harbaum/ftduino32/README.md

# ftDuino32

The ftDuino32 is the big brother of the [ftDuino](http://ftDuino.de). Read [more about the ftDuino32](https://harbaum.github.io/ftduino32/www/).

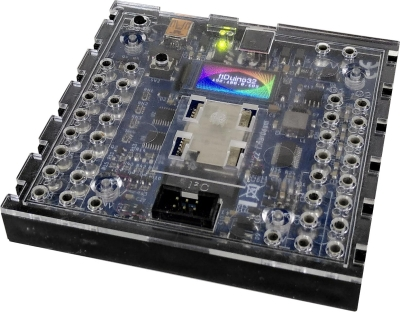
[picture p1: www/images/ftduino32.jpg]
