harbaum/ftduino32/micropython/README.md

# ftDuino32 MicroPython

MicroPython core for the ftDuino32. The files here are used by
[uPIDE](http://github.com/harbaum/upide) when flashing a ftDuino32.

## [ftduino32-20230504-v1.20.0.bin](ftduino32-20230504-v1.20.0.bin)

- MicroPython v1.20.0
- [esp32_machine_counter branch](https://github.com/jonathanhogg/micropython/tree/esp32_machine_counter)
- [MAC address patch applied](modmachine_mac_addr.patch)
- Built with ESP-IDF 4.4.4
