harbaum/ftduino32/www/images/arduino_lab.png

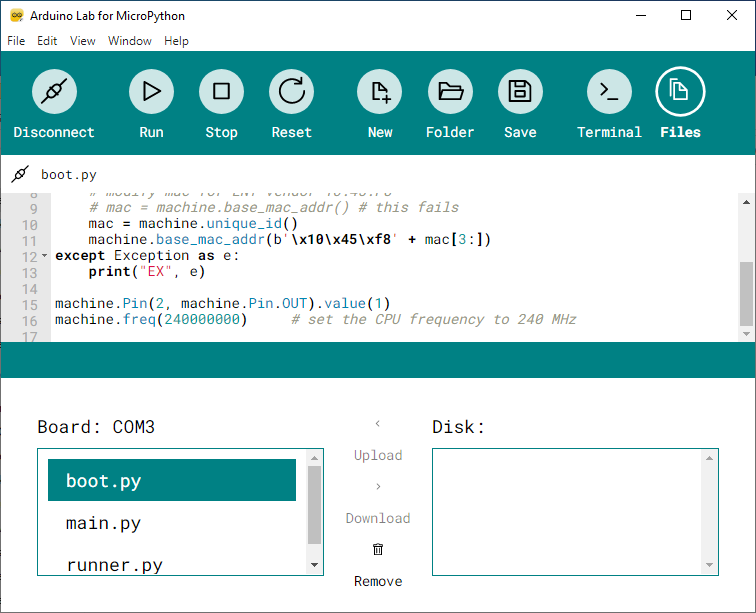
www/images/arduino_lab.png
