harbaum/ftduino32/www/images/mpy_jama.png

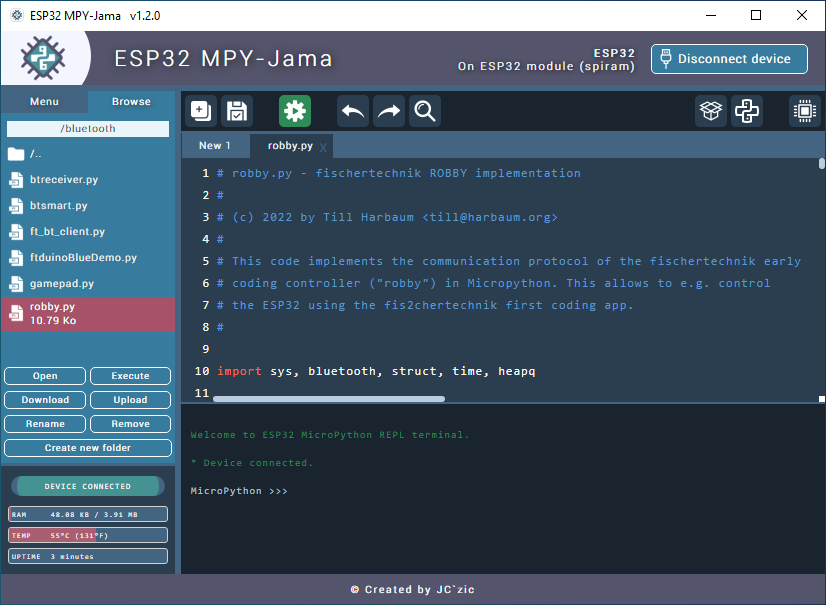
www/images/mpy_jama.png
