harbaum/ftduino32/www/images/pycharm.png

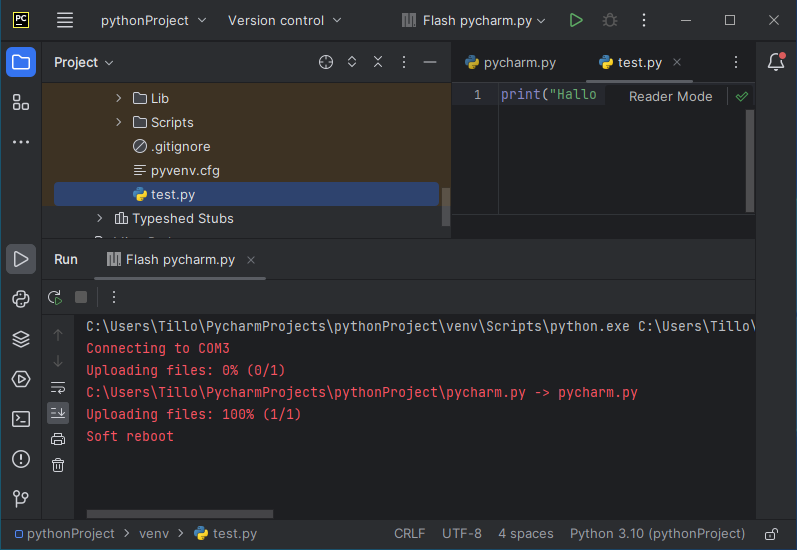
www/images/pycharm.png
