harbaum/ftduino32/www/images/thonny.png

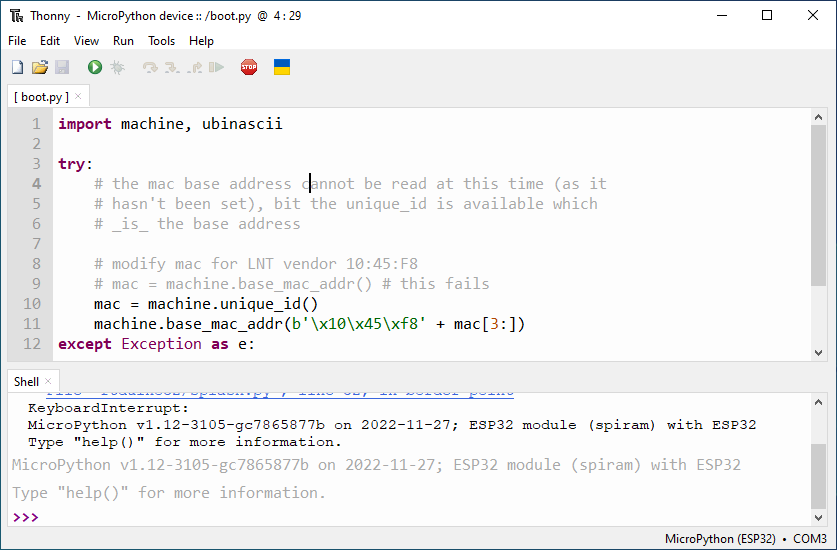
www/images/thonny.png
