harbaum/ftduino32/www/images/upide.png

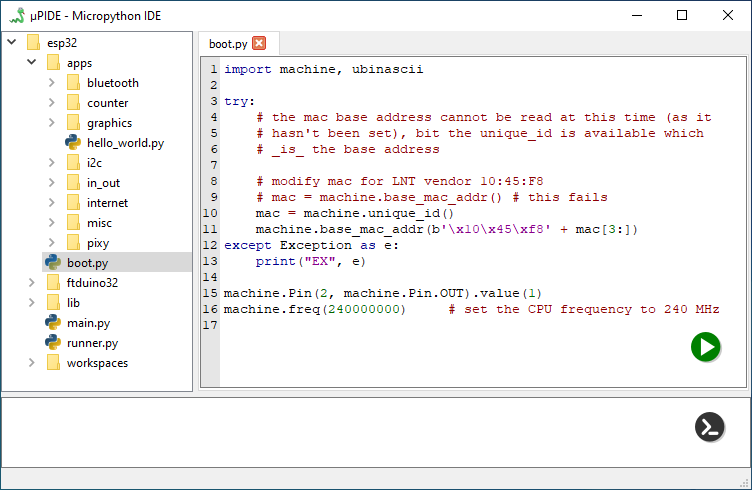
www/images/upide.png
