harbaum/ftduino32/hardware/3d/HRO  TYPE-C-31-M-12.step

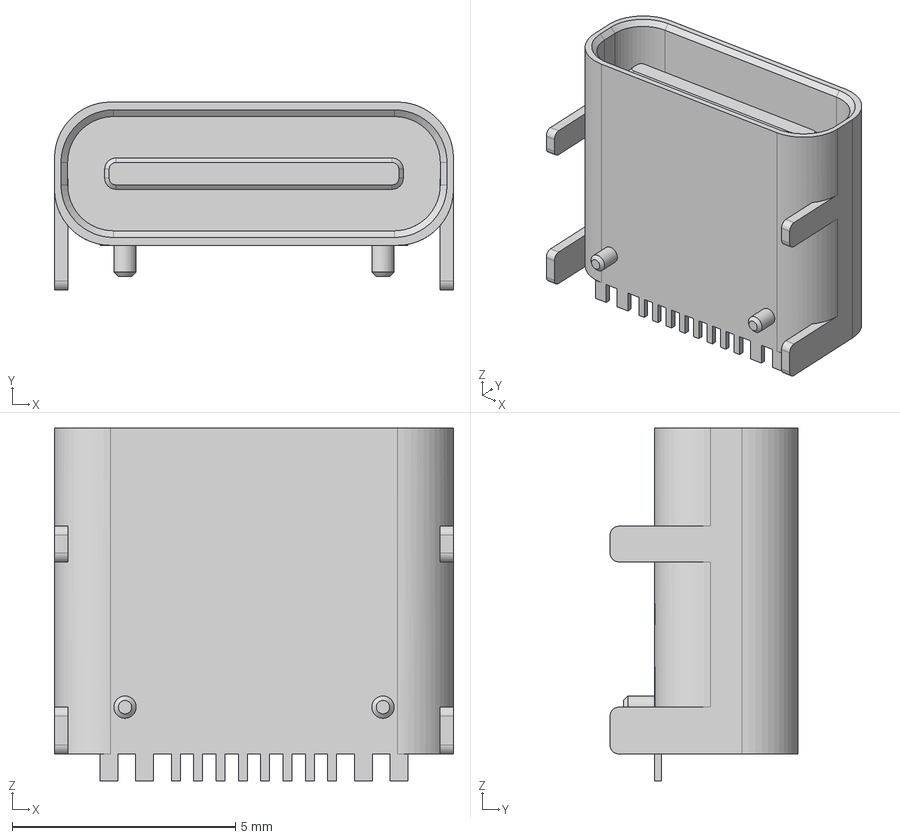
[picture p7: CAD file, 2023-12-07]
hardware/3d/HRO TYPE-C-31-M-12.step
8.94 x 4.21 x 7.90 mm
