harbaum/ftduino32/hardware/ftduino32.kicad_pcb

## KiCad design hardware/ftduino32.kicad_pcb (2023-12-07)

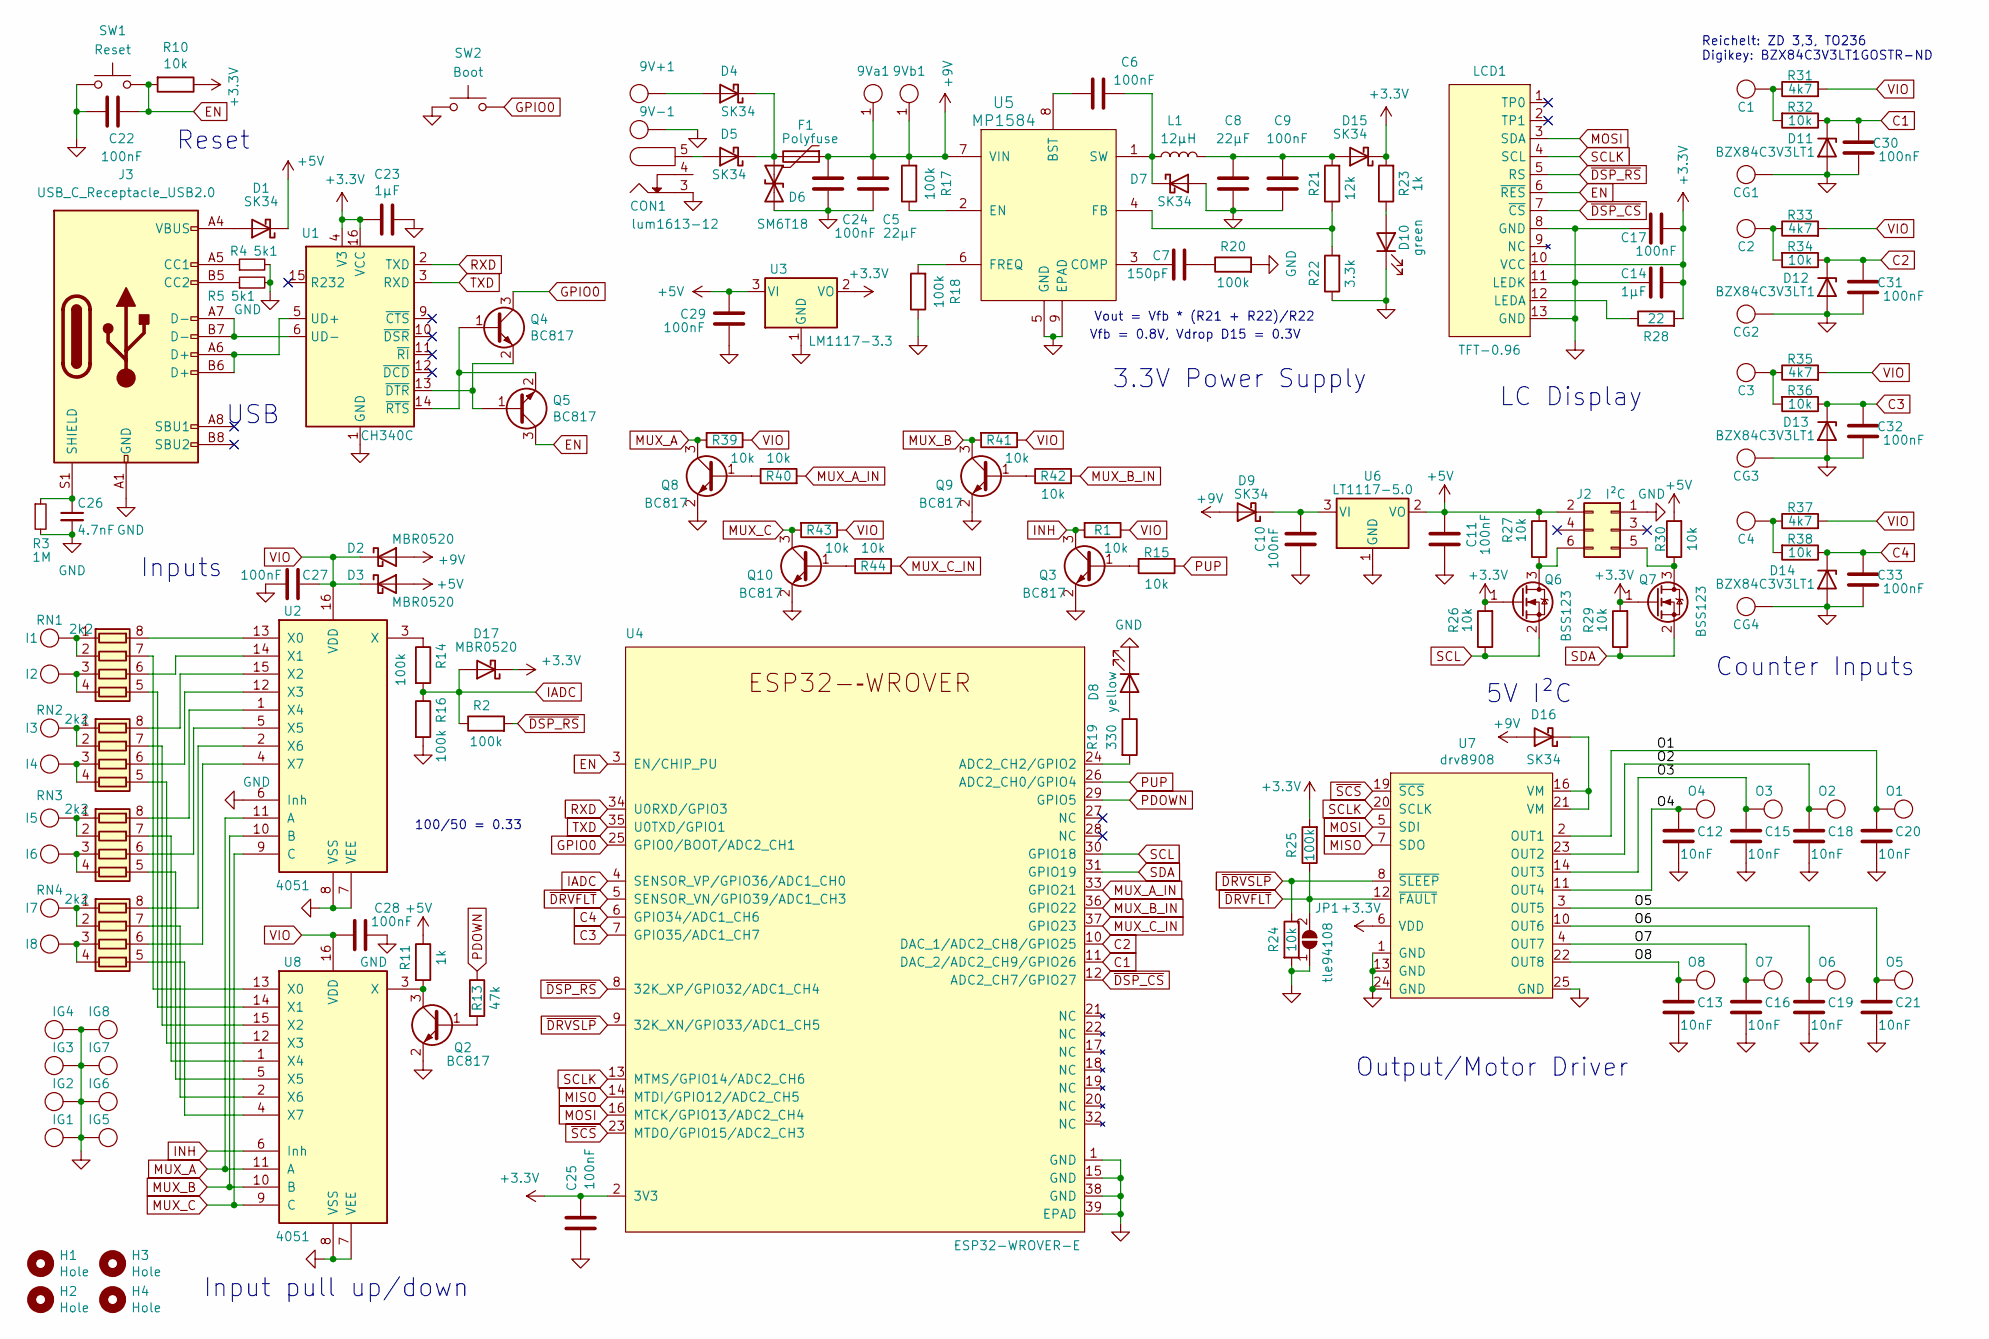
[picture p8: schematic ftduino32.kicad_sch]

Parts:
9V+1, 9V-1, 9Va1, 9Vb1: Sleeve; sleeve
C1, C2, C3, C4: Sleeve; sleeve
C5, C8: 22µF; C_1206_3216Metric; LCSC C12891
C6, C9, C10, C11, C17, C22, C24, C25, C27, C28, C29, C30, C31, C32, C33: 100nF; C_0805_2012Metric
C7: 150pF; C_0805_2012Metric
C12, C13, C15, C16, C18, C19, C20, C21: 10nF; C_0805_2012Metric
C14, C23: 1µF; C_0805_2012Metric
C26: 4.7nF; C_0805_2012Metric
CG1, CG2, CG3, CG4: Sleeve; sleeve
CON1: lum1613-12
D1, D4, D5, D7, D9, D15, D16: SK34; D_SMA; LCSC C8678
D2, D3, D17: MBR0520; D_SOD-123
D6: SM6T18; D_SMB
D8: yellow; LED_0805_2012Metric; LCSC C2296
D10: green; LED_0805_2012Metric; LCSC C2297
D11, D12, D13, D14: BZX84C3V3LT1; D_SOT-23_ANK; JLCPCB Rotation Offset 180
F1: Polyfuse; Fuse_1812_4532Metric; LCSC C207074
H1, H2, H3, H4: Hole; MountingHole_3mm
I1, I2, I3, I4, I5, I6, I7, I8: Sleeve; sleeve
IG1, IG2, IG3, IG4, IG5, IG6, IG7, IG8: Sleeve; sleeve
J2: I²C; PinHeader_2x03_P2.54mm_Vertical
J3: USB_C_Receptacle_USB2.0; TYPE-C-31-M-12; LCSC Part # C2927037
JP1: tle94108; SolderJumper-2_P1.3mm_Open_RoundedPad1.0x1.5mm
L1: 12µH; L_Abracon_ASPI-0630LR; LCSC C380177
LCD1: TFT-0.96
O1, O2, O3, O4, O5, O6, O7, O8: Sleeve; sleeve
Q2, Q3, Q4, Q5, Q8, Q9, Q10: BC817; SOT-23; JLCPCB Rotation Offset 180
Q6, Q7: BSS123; SOT-23; JLCPCB Rotation Offset 180
R1, R10, R15, R24, R26, R27, R29, R30, R32, R34, R36, R38, R39, R40, R41, R42, R43, R44: 10k; R_0805_2012Metric
R2, R14, R16, R17, R18, R20, R25: 100k; R_0805_2012Metric
R3: 1M; R_0805_2012Metric
R4, R5: 5k1; R_0805_2012Metric
R11, R23: 1k; R_0805_2012Metric
R13: 47k; R_0805_2012Metric
R19: 330; R_0805_2012Metric
R21: 12k; R_0805_2012Metric
R22: 3.3k; R_0805_2012Metric
R28: 22; R_0805_2012Metric
R31, R33, R35, R37: 4k7; R_0805_2012Metric
RN1, RN2, RN3, RN4: 2k2; R_Array_Convex_4x0603; JLCPCB Rotation Offset 90
SW1: Reset; SW_SPST_PTS645; LCSC C2837533
SW2: Boot; SW_SPST_PTS645; LCSC C2837533
U1: CH340C; SOIC-16_3.9x9.9mm_P1.27mm; JLCPCB Rotation Offset -90
U2, U8: 4051; TSSOP-16_4.4x5mm_P0.65mm; JLCPCB Rotation Offset -90
U3: LM1117-3.3; SOT-223-3_TabPin2; LCSC C6186
U4: ESP32-WROVER-E; JLCPCB Position Offset 0,-3.175
U5: MP1584; SOIC-8-1EP_3.9x4.9mm_P1.27mm_EP2.514x3.2mm_ThermalVias; JLCPCB Rotation Offset -90
U6: LT1117-5.0; SOT-223-3_TabPin2; JLCPCB Rotation Offset 180
U7: drv8908; HTSSOP-24-1EP_4.4x7.8mm_P0.65mm_EP3.4x7.8mm_Mask2.4x4.68mm_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

Connections:
+3V3: C14.1, C17.1, C23.2, C25.2, D15.1 (K), D17.1 (K), LCD1.10 (VCC), Q6.1 (G), Q7.1 (G), R10.1, R23.2, R25.2, R26.2, R28.2, R29.2, U1.4 (V3), U1.16 (VCC), U3.2 (VO), U4.2 (3V3), U7.6 (VDD)
+5V: C11.2, C29.2, D1.1 (K), D3.2 (A), J2.2, R11.1, R27.2, R30.2, U3.3 (VI), U6.2 (VO)
+9V: 9Va1.1, 9Vb1.1, C5.2, C24.2, D2.2 (A), D9.2 (A), D16.2 (A), F1.1, R17.2, U5.7 (VIN)
/O1: C20.2, O1.1, U7.2 (OUT1)
/O2: C18.2, O2.1, U7.23 (OUT2)
/O3: C15.2, O3.1, U7.14 (OUT3)
/O4: C12.2, O4.1, U7.11 (OUT4)
/O5: C21.2, O5.1, U7.3 (OUT5)
/O6: C19.2, O6.1, U7.10 (OUT6)
/O7: C16.2, O7.1, U7.4 (OUT7)
/O8: C13.2, O8.1, U7.22 (OUT8)
C1: C30.2, D11.1 (K), R32.1, U4.11 (DAC_2/ADC2_CH9/GPIO26)
C2: C31.2, D12.1 (K), R34.1, U4.10 (DAC_1/ADC2_CH8/GPIO25)
C3: C32.2, D13.1 (K), R36.1, U4.7 (GPIO35/ADC1_CH7)
C4: C33.2, D14.1 (K), R38.1, U4.6 (GPIO34/ADC1_CH6)
EN: C22.1, LCD1.6 (~RES), Q5.3 (C), R10.2, SW1.2, U4.3 (EN/CHIP_PU)
GND: 9V-1.1, C5.1, C8.1, C9.1, C10.1, C11.1, C12.1, C13.1, C14.2, C15.1, C16.1, C17.2, C18.1, C19.1, C20.1, C21.1, C22.2, C23.1, C24.1, C25.1, C26.2, C27.2, C28.1, C29.1, C30.1, C31.1, C32.1, C33.1, CG1.1, CG2.1, CG3.1, CG4.1, CON1.3, D6.2 (A2), D7.2 (A), D8.1 (K), D10.1 (K), D11.2 (A), D12.2 (A), D13.2 (A), D14.2 (A), IG1.1, IG2.1, IG3.1, IG4.1, IG5.1, IG6.1, IG7.1, IG8.1, J2.1, J3.A1 (GND), J3.A12 (GND), J3.B1 (GND), J3.B12 (GND), JP1.1 (A), LCD1.8 (GND), LCD1.11 (LEDK), LCD1.13 (GND), Q2.2 (E), Q3.2 (E), Q8.2 (E), Q9.2 (E), Q10.2 (E), R3.2, R4.2, R5.2, R16.2, R18.1, R20.2, R22.1, R24.2, SW1.1, SW2.1, U1.1 (GND), U2.6 (Inh), U2.7 (VEE), U2.8 (VSS), U3.1 (GND), U4.1 (GND), U4.15 (GND), U4.38 (GND), U4.39 (EPAD), U5.5 (GND), U5.9 (EPAD), U6.1 (GND), U7.1 (GND), U7.13 (GND), U7.24 (GND), U7.25 (GND), U8.7 (VEE), U8.8 (VSS)
GPIO0: Q4.3 (C), SW2.2, U4.25 (GPIO0/BOOT/ADC2_CH1)
IADC: D17.2 (A), R2.1, R14.2, R16.1, U4.4 (SENSOR_VP/GPIO36/ADC1_CH0)
INH: Q3.3 (C), R1.2, U8.6 (Inh)
MISO: U4.14 (MTDI/GPIO12/ADC2_CH5), U7.7 (SDO)
MOSI: LCD1.3 (SDA), U4.16 (MTCK/GPIO13/ADC2_CH4), U7.5 (SDI)
MUX_A: Q8.3 (C), R39.2, U2.11 (A), U8.11 (A)
MUX_A_IN: R40.2, U4.33 (GPIO21)
MUX_B: Q9.3 (C), R41.2, U2.10 (B), U8.10 (B)
MUX_B_IN: R42.2, U4.36 (GPIO22)
MUX_C: Q10.3 (C), R43.2, U2.9 (C), U8.9 (C)
MUX_C_IN: R44.2, U4.37 (GPIO23)
unnamed: C1.1, R31.1, R32.2
unnamed: C2.1, R33.1, R34.2
unnamed: C3.1, R35.1, R36.2
unnamed: C4.1, R37.1, R38.2
unnamed: C7.2, R20.1
unnamed: D1.2 (A), J3.A4 (VBUS), J3.A9 (VBUS), J3.B4 (VBUS), J3.B9 (VBUS)
unnamed: 9V+1.1, D4.2 (A)
unnamed: D4.1 (K), D5.1 (K), D6.1 (A1), F1.2
unnamed: CON1.5, D5.2 (A)
unnamed: C6.2, D7.1 (K), L1.1, U5.1 (SW)
unnamed: D8.2 (A), R19.1
unnamed: C10.2, D9.1 (K), U6.3 (VI)
unnamed: D10.2 (A), R23.1
unnamed: C8.2, C9.2, D15.2 (A), L1.2, R21.2
unnamed: D16.1 (K), U7.16 (VM), U7.21 (VM)
unnamed: J2.5, Q7.3 (D), R30.1
unnamed: J2.6, Q6.3 (D), R27.1
unnamed: J3.A5 (CC1), R4.1
unnamed: J3.B5 (CC2), R5.1
unnamed: C26.1, J3.S1 (SHIELD), R3.1
unnamed: LCD1.12 (LEDA), R28.1
unnamed: Q2.1 (B), R13.2
unnamed: Q2.3 (C), R11.2, U8.3 (X)
unnamed: Q3.1 (B), R15.2
unnamed: Q4.1 (B), Q5.2 (E), U1.14 (~RTS)
unnamed: Q4.2 (E), Q5.1 (B), U1.13 (~DTR)
unnamed: Q8.1 (B), R40.1
unnamed: Q9.1 (B), R42.1
unnamed: Q10.1 (B), R44.1
unnamed: I1.1, RN1.1 (R1.1), RN1.2 (R2.1)
unnamed: RN1.8 (R1.2), U2.13 (X0)
unnamed: RN1.7 (R2.2), U8.13 (X0)
unnamed: I2.1, RN1.3 (R3.1), RN1.4 (R4.1)
unnamed: RN1.6 (R3.2), U2.14 (X1)
unnamed: RN1.5 (R4.2), U8.14 (X1)
unnamed: I3.1, RN2.1 (R1.1), RN2.2 (R2.1)
unnamed: RN2.8 (R1.2), U2.15 (X2)
unnamed: RN2.7 (R2.2), U8.15 (X2)
unnamed: I4.1, RN2.3 (R3.1), RN2.4 (R4.1)
unnamed: RN2.6 (R3.2), U2.12 (X3)
unnamed: RN2.5 (R4.2), U8.12 (X3)
unnamed: I5.1, RN3.1 (R1.1), RN3.2 (R2.1)
unnamed: RN3.8 (R1.2), U2.1 (X4)
unnamed: RN3.7 (R2.2), U8.1 (X4)
unnamed: I6.1, RN3.3 (R3.1), RN3.4 (R4.1)
unnamed: RN3.6 (R3.2), U2.5 (X5)
unnamed: RN3.5 (R4.2), U8.5 (X5)
unnamed: I7.1, RN4.1 (R1.1), RN4.2 (R2.1)
unnamed: RN4.8 (R1.2), U2.2 (X6)
unnamed: RN4.7 (R2.2), U8.2 (X6)
unnamed: I8.1, RN4.3 (R3.1), RN4.4 (R4.1)
unnamed: RN4.6 (R3.2), U2.4 (X7)
unnamed: RN4.5 (R4.2), U8.4 (X7)
unnamed: J3.A6 (D+), J3.B6 (D+), U1.5 (UD+)
unnamed: J3.A7 (D-), J3.B7 (D-), U1.6 (UD-)
unnamed: R14.1, U2.3 (X)
unnamed: R19.2, U4.24 (ADC2_CH2/GPIO2)
unnamed: C6.1, U5.8 (BST)
unnamed: C7.1, U5.3 (COMP)
unnamed: R17.1, U5.2 (EN)
unnamed: R21.1, R22.2, U5.4 (FB)
unnamed: R18.2, U5.6 (FREQ)
PDOWN: R13.1, U4.29 (GPIO5)
PUP: R15.1, U4.26 (ADC2_CH0/GPIO4)
RXD: U1.2 (TXD), U4.34 (U0RXD/GPIO3)
SCL: Q6.2 (S), R26.1, U4.30 (GPIO18)
SCLK: LCD1.4 (SCL), U4.13 (MTMS/GPIO14/ADC2_CH6), U7.20 (SCLK)
SDA: Q7.2 (S), R29.1, U4.31 (GPIO19)
TXD: U1.3 (RXD), U4.35 (U0TXD/GPIO1)
VIO: C27.1, C28.2, D2.1 (K), D3.1 (K), R1.1, R31.2, R33.2, R35.2, R37.2, R39.1, R41.1, R43.1, U2.16 (VDD), U8.16 (VDD)
~DRVFLT: JP1.2 (B), R25.1, U4.5 (SENSOR_VN/GPIO39/ADC1_CH3), U7.12 (~FAULT)
~DRVSLP: R24.1, U4.9 (32K_XN/GPIO33/ADC1_CH5), U7.8 (~SLEEP)
~DSP_CS: LCD1.7 (~CS), U4.12 (ADC2_CH7/GPIO27)
~DSP_RS: LCD1.5 (RS), R2.2, U4.8 (32K_XP/GPIO32/ADC1_CH4)
~SCS: U4.23 (MTDO/GPIO15/ADC2_CH3), U7.19 (~SCS)

Notes on the sheet:
5V I²C
Input pull up/down
Reset
Output/Motor Driver
Vout = Vfb * (R21 + R22)/R22
3.3V Power Supply
Counter Inputs
Inputs
100/50 = 0.33
USB
LC Display
Vfb = 0.8V, Vdrop D15 = 0.3V
Reichelt: ZD 3,3, TO236 Digikey: BZX84C3V3LT1GOSTR-ND

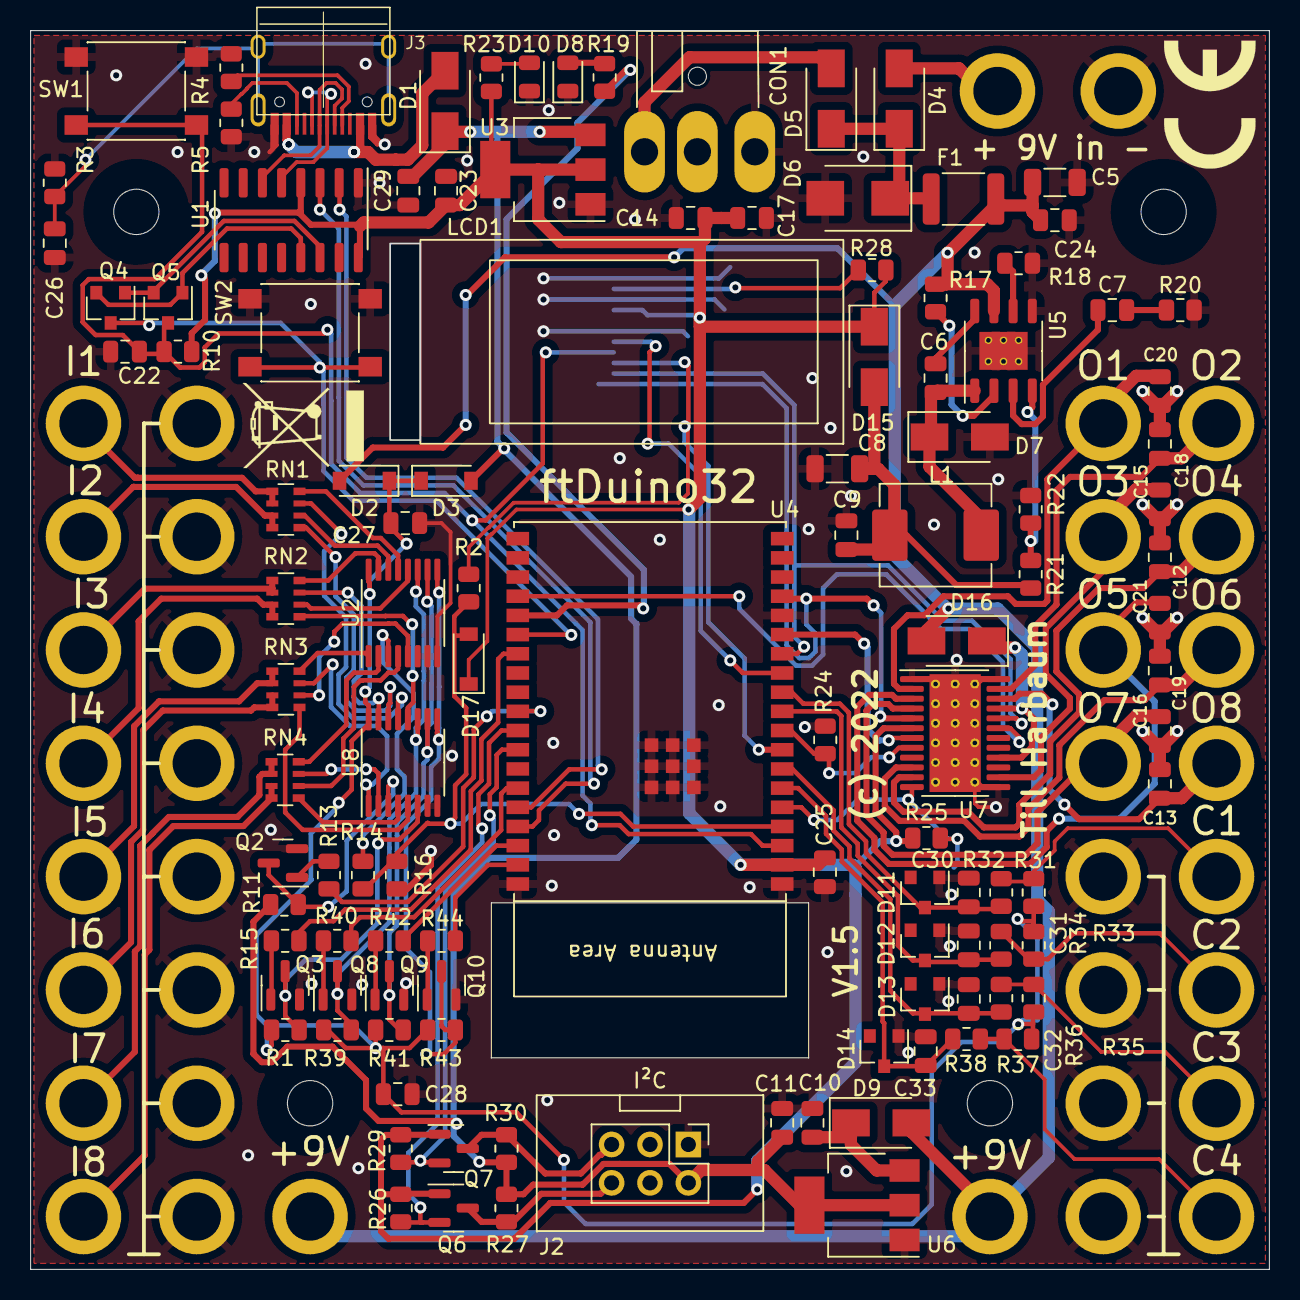
[picture p9: board ftduino32.kicad_pcb from above]

Board: 2 copper layers, 82.0 x 82.0 mm, 155 parts (1 on the bottom side), 103 nets.
