harbaum/ftduino32/www/images/wifi_setup.png

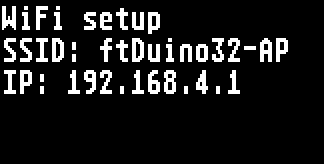
www/images/wifi_setup.png
