harbaum/ftduino32/www/images/wifi_setup_enter.png

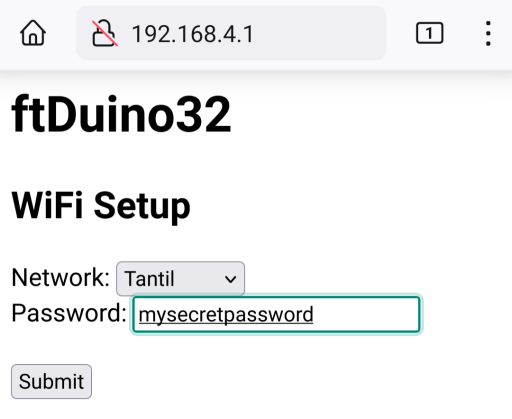
www/images/wifi_setup_enter.png
