harbaum/ftduino32/www/images/wifi_setup_ip_set.png

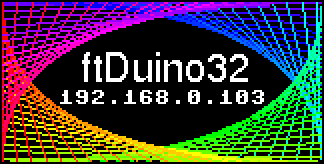
www/images/wifi_setup_ip_set.png
