harbaum/ftduino32/www/images/wifi_setup_reboot.png

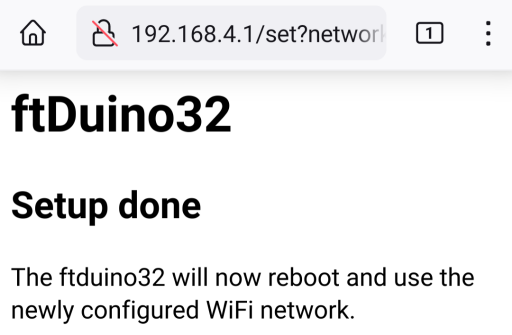
www/images/wifi_setup_reboot.png
