harbaum/ftduino32/www/images/wifi_setup_select_ftduino32_ap.png

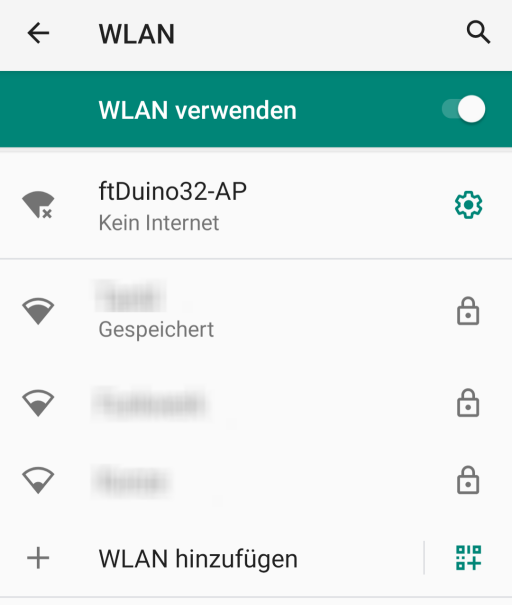
www/images/wifi_setup_select_ftduino32_ap.png
