harbaum/ftduino32/www/images/wifi_setup_simple_web.png

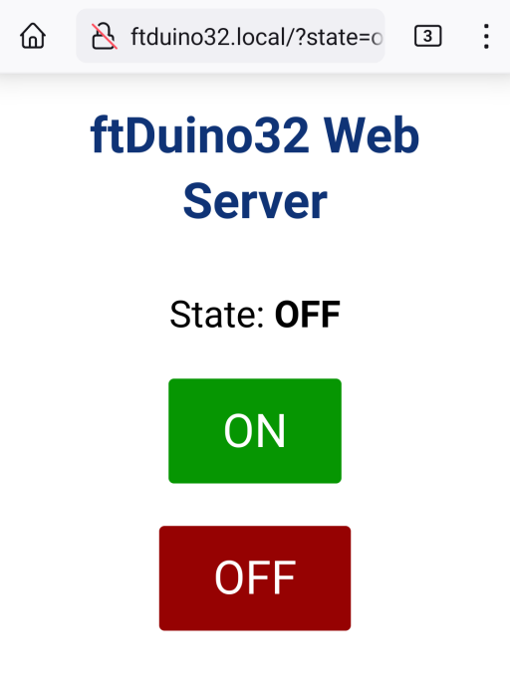
www/images/wifi_setup_simple_web.png
