harbaum/ftduino32/(notices)

Notices in the files:
hardware/ftduino32.kicad_pcb:
(c) 2022
